hotchk155/banana-split/docs/dimensions.txt

4.375
4.625
4.875

0.25"
0.25"
0.4"

y = 0.555
sockets at y=0.53"
.025"

end of board 5.545
