hotchk155/banana-split/docs/banana.bmp

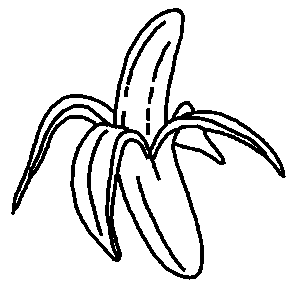
docs/banana.bmp
