hotchk155/banana-split/docs/schem.png

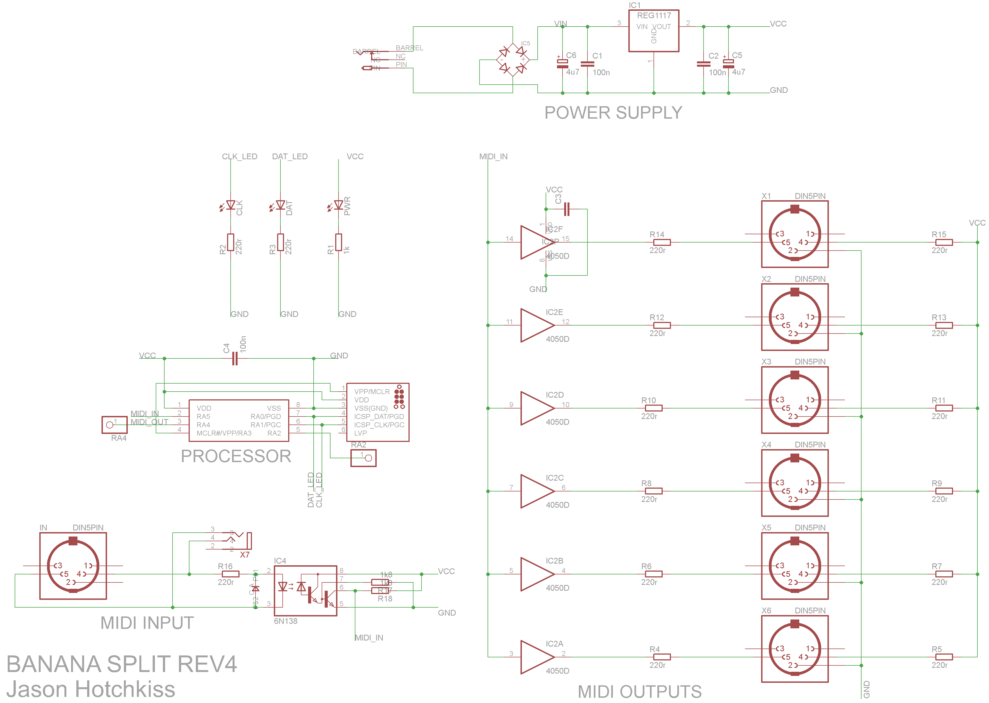
docs/schem.png
