hotchk155/banana-split/docs/banana-split-BOM.xlsx

BANANA SPLIT MIDI THRU - BILL OF MATERIALS
SIXTY FOUR PIXELS LIMITED
SURFACE MOUNT COMPONENTS
Designator | Value | Package | Manufacturer | Description | Source
R1 | 1k | 0805 | GENERIC | RESISTOR | SUPPLIER TO SOURCE
R2 | 220r | 0805 | GENERIC | RESISTOR | SUPPLIER TO SOURCE
R3 | 220r | 0805 | GENERIC | RESISTOR | SUPPLIER TO SOURCE
R4 | 220r | 0805 | GENERIC | RESISTOR | SUPPLIER TO SOURCE
R5 | 220r | 0805 | GENERIC | RESISTOR | SUPPLIER TO SOURCE
R6 | 220r | 0805 | GENERIC | RESISTOR | SUPPLIER TO SOURCE
R7 | 220r | 0805 | GENERIC | RESISTOR | SUPPLIER TO SOURCE
R8 | 220r | 0805 | GENERIC | RESISTOR | SUPPLIER TO SOURCE
R9 | 220r | 0805 | GENERIC | RESISTOR | SUPPLIER TO SOURCE
R10 | 220r | 0805 | GENERIC | RESISTOR | SUPPLIER TO SOURCE
R11 | 220r | 0805 | GENERIC | RESISTOR | SUPPLIER TO SOURCE
R12 | 220r | 0805 | GENERIC | RESISTOR | SUPPLIER TO SOURCE
R13 | 220r | 0805 | GENERIC | RESISTOR | SUPPLIER TO SOURCE
R14 | 220r | 0805 | GENERIC | RESISTOR | SUPPLIER TO SOURCE
R15 | 220r | 0805 | GENERIC | RESISTOR | SUPPLIER TO SOURCE
R16 | 220r | 0805 | GENERIC | RESISTOR | SUPPLIER TO SOURCE
R17 | 1k5 | 0805 | GENERIC | RESISTOR | SUPPLIER TO SOURCE
R18 | 1k5 | 0805 | GENERIC | RESISTOR | SUPPLIER TO SOURCE
R24 | 1k | 0805 | GENERIC | RESISTOR | SUPPLIER TO SOURCE
A | 0R | 0805 | GENERIC | RESISTOR | SUPPLIER TO SOURCE
B | Do not popupulate
C | 0R | 0805 | GENERIC | RESISTOR | SUPPLIER TO SOURCE
D | Do not popupulate
E | Do not popupulate
F | Do not popupulate
C1 | 100nF | 0805 | GENERIC | CERAMIC CAPACITOR | SUPPLIER TO SOURCE
C2 | 100nF | 0805 | GENERIC | CERAMIC CAPACITOR | SUPPLIER TO SOURCE
C3 | 100nF | 0805 | GENERIC | CERAMIC CAPACITOR | SUPPLIER TO SOURCE
C4 | 100nF | 0805 | GENERIC | CERAMIC CAPACITOR | SUPPLIER TO SOURCE
C7 | 10nF (TEN) | 0805 | GENERIC | CERAMIC CAPACITOR | SUPPLIER TO SOURCE
D1 | TS4148 | 0805 | GENERIC | SMALL SIGNAL DIODE | SUPPLIED BY CUSTOMER
D2 | MBR0520 | SOD123 | GENERIC | SCHOTTKY DIODE
D3 | MBR0520 | SOD123 | GENERIC | SCHOTTKY DIODE
D4 | MBR0520 | SOD123 | GENERIC | SCHOTTKY DIODE
D5 | MBR0520 | SOD123 | GENERIC | SCHOTTKY DIODE
IC1 | LD1117S50CTR | SOT-223-3 | ST MICRO | +5V VOLTAGE REGULATOR | SUPPLIED BY CUSTOMER
IC2 | CD4050BD | SOIC-16 | TEXAS INSTRUMENTS | HEX NONINVERTING BUFFER | SUPPLIED BY CUSTOMER
IC3 | PIC12F1822-I/P | SOIC-8 | MICROCHIP | MICROCONTROLLER | SUPPLIED BY CUSTOMER
THRU HOLE COMPONENTS (DO NOT POPULATE)
C5 | 4.7uF/ 50V | RADIAL 2MM PITCH | GENERIC | ALUMINIUM ELECTROLYTIC CAPACITOR | DO NOT POPULATE
C6 | 4.7uF/ 50V | RADIAL 2MM PITCH | GENERIC | ALUMINIUM ELECTROLYTIC CAPACITOR | DO NOT POPULATE
IC4 | 6N138 | DIP-8 | GENERIC | OPTO ISOLATOR DARLINGTON OUTPUT | DO NOT POPULATE
CLK | BLUE | 2 x 5 x 7 mm | GENERIC | RECTANGULAR LENS LED | DO NOT POPULATE
DAT | YELLOW | 2 x 5 x 7 mm | GENERIC | RECTANGULAR LENS LED | DO NOT POPULATE
PWR | RED | 2 x 5 x 7 mm | GENERIC | RECTANGULAR LENS LED | DO NOT POPULATE
IN | DS1093-07-BN50X |  | TRUCONNECT | 5 Way 180 Degree DIN PCB Socket | DO NOT POPULATE
X1 | DS1093-07-BN50X |  | TRUCONNECT | 5 Way 180 Degree DIN PCB Socket | DO NOT POPULATE
X2 | DS1093-07-BN50X |  | TRUCONNECT | 5 Way 180 Degree DIN PCB Socket | DO NOT POPULATE
X3 | DS1093-07-BN50X |  | TRUCONNECT | 5 Way 180 Degree DIN PCB Socket | DO NOT POPULATE
X4 | DS1093-07-BN50X |  | TRUCONNECT | 5 Way 180 Degree DIN PCB Socket | DO NOT POPULATE
X5 | DS1093-07-BN50X |  | TRUCONNECT | 5 Way 180 Degree DIN PCB Socket | DO NOT POPULATE
X6 | DS1093-07-BN50X |  | TRUCONNECT | 5 Way 180 Degree DIN PCB Socket | DO NOT POPULATE
X7 | PJ-360 |  | TRUCONNECT | UNSWITCHED STEREO VERTICAL JACK SOCKET | DO NOT POPULATE
X8 | AD-426A |  | RVFM (RAPID) | 2.1MM DC POWER SOCKET | DO NOT POPULATE
