hotchk155/banana-split/hardware/banana-split-bom-jlc.xls

Comment | Designator | Footprint | JLCPCB Part #
MBR0520 | D5,D3,D2,D4,D5,D3,D2,D4,D5,D3,D2,D4,D5,D3,D2,D4 | SOD-123 | C23848
1k | R1,R24,R1,R24 | 0805 | C17513
CD4050BD | IC2 | SO16 | C352821
TS4148 | D1 | 0805 | C109001
PIC12F1822-I/P | IC3 | SO08 | C60039
220r | R6,R12,R13,R15,R16,R2,R4,R7,R9,R11,R14,R5,R3,R10,R8,R6,R12,R13,R15,R16,R2,R4,R7,R9,R11,R14,R5,R3,R10,R8,R6,R12,R13,R15,R16,R2,R4,R7,R9,R11,R14,R5,R3,R10,R8,R6,R12,R13,R15,R16,R2,R4,R7,R9,R11,R14,R5,R3,R10,R8,R6,R12,R13,R15,R16,R2,R4,R7,R9,R11,R14,R5,R3,R10,R8,R6,R12,R13,R15,R16,R2,R4,R7,R9,R11,R14,R5,R3,R10,R8,R6,R12,R13,R15,R16,R2,R4,R7,R9,R11,R14,R5,R3,R10,R8,R6,R12,R13,R15,R16,R2,R4,R7,R9,R11,R14,R5,R3,R10,R8,R6,R12,R13,R15,R16,R2,R4,R7,R9,R11,R14,R5,R3,R10,R8,R6,R12,R13,R15,R16,R2,R4,R7,R9,R11,R14,R5,R3,R10,R8,R6,R12,R13,R15,R16,R2,R4,R7,R9,R11,R14,R5,R3,R10,R8,R6,R12,R13,R15,R16,R2,R4,R7,R9,R11,R14,R5,R3,R10,R8,R6,R12,R13,R15,R16,R2,R4,R7,R9,R11,R14,R5,R3,R10,R8,R6,R12,R13,R15,R16,R2,R4,R7,R9,R11,R14,R5,R3,R10,R8,R6,R12,R13,R15,R16,R2,R4,R7,R9,R11,R14,R5,R3,R10,R8 | 0805 | C17557
1k5 | R18,R17,R18,R17 | 0805 | C4310
100nF | C3,C4,C7,C2,C1,C3,C4,C7,C2,C1,C3,C4,C7,C2,C1,C3,C4,C7,C2,C1,C3,C4,C7,C2,C1 | 0805 | C49678
LD1117S50CTR | IC1 | SOT223 | C81157
