hotchk155/banana-split/hardware/banana-split-bom.xlsx

Comment | Designator | Footprint | JLCPCB Part #（optional）
0r | A | 0805
DNP | B
0r | C | 0805
100nF | C1 | 0805
100nF | C2 | 0805
100nF | C3 | 0805
100nF | C4 | 0805
100nF | C7 | 0805
DNP | D
TS4148 | D1 | 0805
MBR0520 | D2 | SOD-123
MBR0520 | D3 | SOD-123
MBR0520 | D4 | SOD-123
MBR0520 | D5 | SOD-123
DNP | E
DNP | F
LD1117S50CTR | IC1 | SOT223
CD4050BD | IC2 | SO16
PIC12F1822-I/P | IC3 | SO08
1k | R1 | 0805
220r | R2 | 0805
220r | R3 | 0805
220r | R4 | 0805
220r | R5 | 0805
220r | R6 | 0805
220r | R7 | 0805
220r | R8 | 0805
220r | R9 | 0805
220r | R10 | 0805
220r | R11 | 0805
220r | R12 | 0805
220r | R13 | 0805
220r | R14 | 0805
220r | R15 | 0805
220r | R16 | 0805
1k5 | R17 | 0805
1k5 | R18 | 0805
1k | R24 | 0805
