hotchk155/banana-split/hardware/banana-split.brd

## EAGLE design hardware/banana-split.brd (2019-09-07)

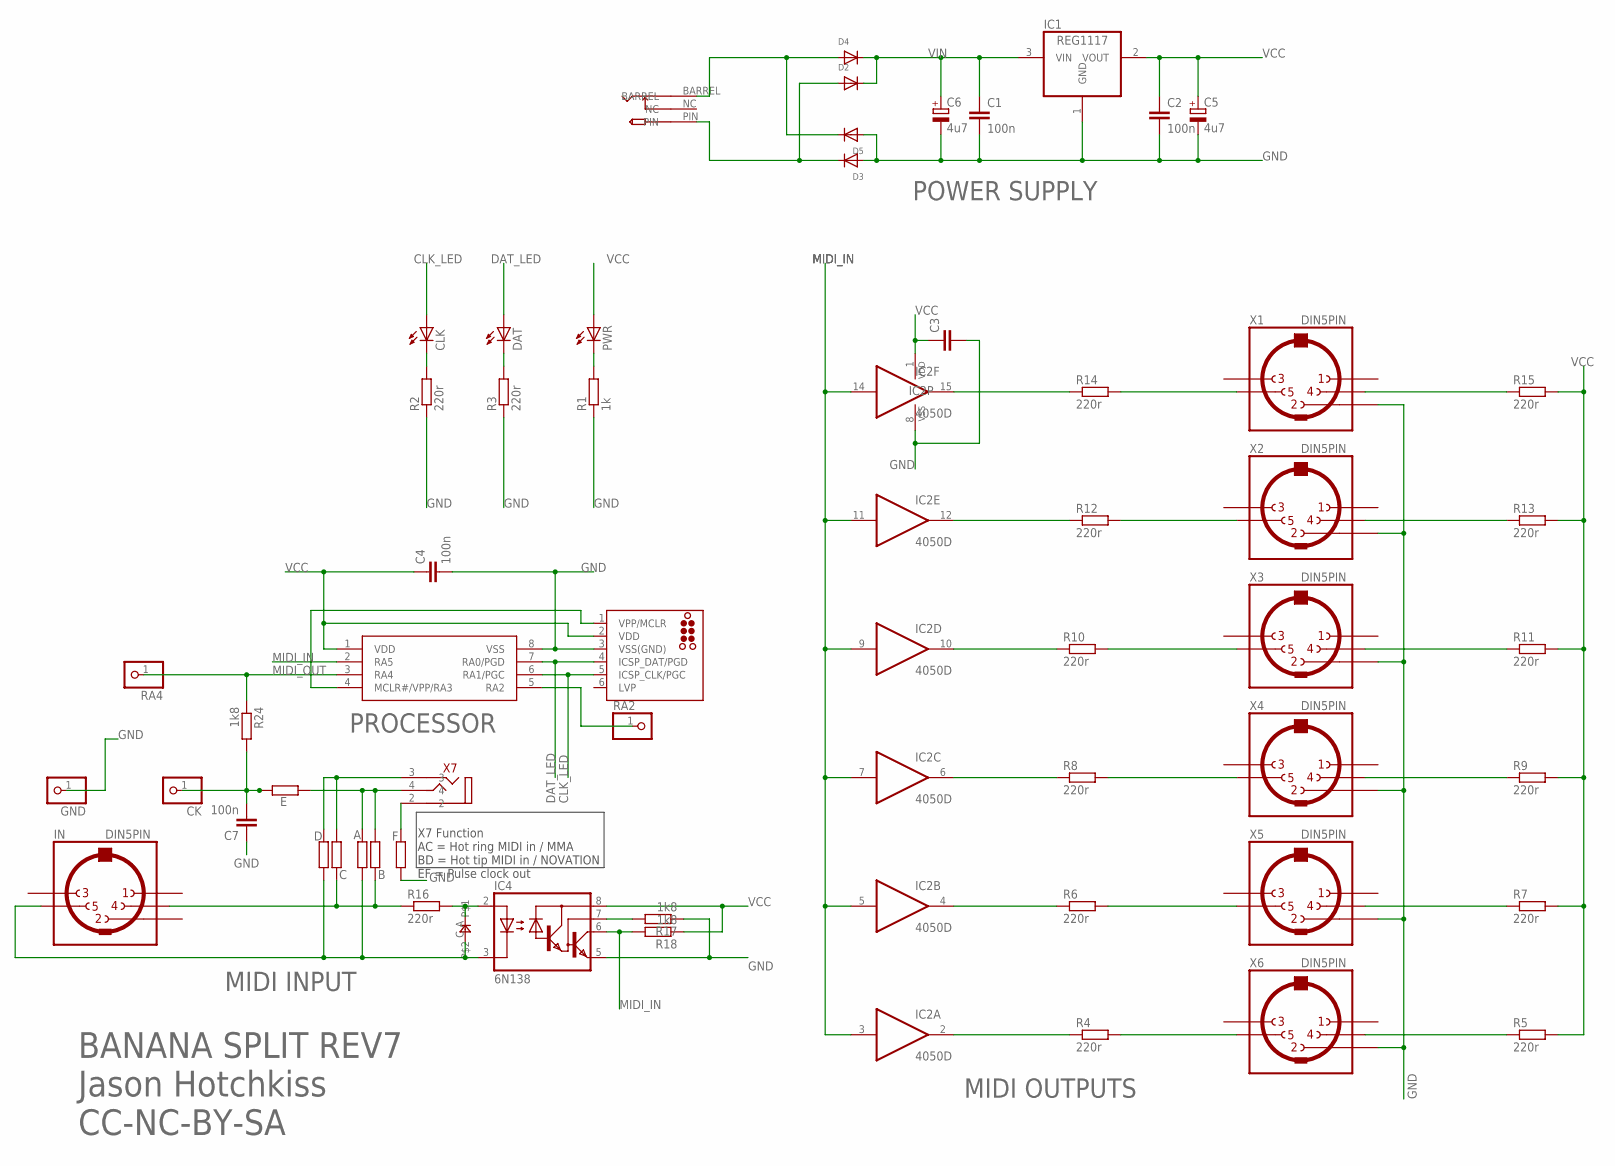
[picture p20: schematic banana-split.sch]

Parts:
A: 1k8; R0805
B: 1k8; R0805
C: 1k8; R0805
C1, C2, C4, C7: 100n; C0805
C3: C-EUC0805; C0805
C5, C6: 4u7; E2-4
CK: PINHD-1X1; 1X01
CLK: LED3MM
D: 1k8; R0805
D1: 0805DIODE
D2, D3, D4, D5: DIODESOD-123; SOD-123
DAT: LED3MM
E: 1k8; R0805
F: 1k8; R0805
GND: PINHD-1X1; 1X01
IC1: REG1117; SOT223
IC2: 4050D; SO16
IC3: PIC12F1822SO08; SO08
IC4: 6N138; DIL08
ICSP: TC2030-MCP-NL
IN: DIN5PIN; EDGEDIN
PWR: LED3MM
R1: 1k; R0805
R2, R3, R4, R5, R6, R7, R8, R9, R10, R11, R12, R13, R14, R15, R16: 220r; R0805
R17, R18, R24: 1k8; R0805
RA2, RA4: PINHD-1X1; 1X01
U$1: PWR_SOCKET_2_1MM
X1, X2, X3, X4, X5, X6: DIN5PIN; EDGEDIN
X7: VERTICAL_3_5MM_SOCKET

Connections:
CLK: CLK.K (C), R2.2
CLK_LED: CLK.A, IC3.6 (RA1/PGC), ICSP.5 (ICSP_CLK/PGC)
DAT_LED: DAT.A, IC3.7 (RA0/PGD), ICSP.4 (ICSP_DAT/PGD)
GND: C1.2, C2.2, C3.2, C4.2, C5.-, C6.-, C7.1, D3.A, D5.A, F.1, GND.1, IC1.1 (GND), IC2.8 (VSS), IC3.8 (VSS), IC4.5 (GND), ICSP.3 (VSS(GND)), R1.1, R2.1, R3.1, R17.1, X1.2, X2.2, X3.2, X4.2, X5.2, X6.2
MIDI_IN: IC2.3 (I), IC2.5 (I), IC2.7 (I), IC2.9 (I), IC2.11 (I), IC2.14 (I), IC3.2 (RA5), IC4.6 (VO), R18.2
MIDI_OUT: IC3.3 (RA4), R24.1, RA4.1
unnamed: R14.2, X1.5
unnamed: R12.2, X2.5
unnamed: R10.2, X3.5
unnamed: R8.2, X4.5
unnamed: R6.2, X5.5
unnamed: R4.2, X6.5
unnamed: IC2.15 (O), R14.1
unnamed: IC2.12 (O), R12.1
unnamed: IC2.10 (O), R10.1
unnamed: IC2.6 (O), R8.1
unnamed: IC2.2 (O), R4.1
unnamed: IC2.4 (O), R6.1
unnamed: PWR.K (C), R1.2
unnamed: R15.1, X1.4
unnamed: R13.1, X2.4
unnamed: R11.1, X3.4
unnamed: R9.1, X4.4
unnamed: R7.1, X5.4
unnamed: R5.1, X6.4
unnamed: B.1, C.1, IN.4, R16.1
unnamed: D1.A, IC4.2 (A), R16.2
unnamed: IC4.7 (VB), R17.2
unnamed: DAT.K (C), R3.2
unnamed: A.1, D.1, D1.C, IC4.3 (C), IN.5
unnamed: IC3.5 (RA2), RA2.1
unnamed: C.2, D.2, X7.3
unnamed: D4.A, D5.C, U$1.BARREL
unnamed: D2.A, D3.C, U$1.PIN
unnamed: F.2, X7.2
unnamed: A.2, B.2, E.2, X7.4
unnamed: C7.2, CK.1, E.1, R24.2
unnamed: IC3.4 (MCLR#/VPP/RA3), ICSP.1 (VPP/MCLR)
VCC: C2.1, C3.1, C4.1, C5.+, IC1.2 (VOUT), IC2.1 (VDD), IC3.1 (VDD), IC4.8 (VCC), ICSP.2 (VDD), PWR.A, R5.2, R7.2, R9.2, R11.2, R13.2, R15.2, R18.1
VIN: C1.1, C6.+, D2.C, D4.C, IC1.3 (VIN)

Notes on the sheet:
POWER SUPPLY
MIDI OUTPUTS
MIDI INPUT
PROCESSOR
BANANA SPLIT REV7
Jason Hotchkiss CC-NC-BY-SA
X7 Function AC = Hot ring MIDI in / MMA BD = Hot tip MIDI in / NOVATION EF = Pulse clock out

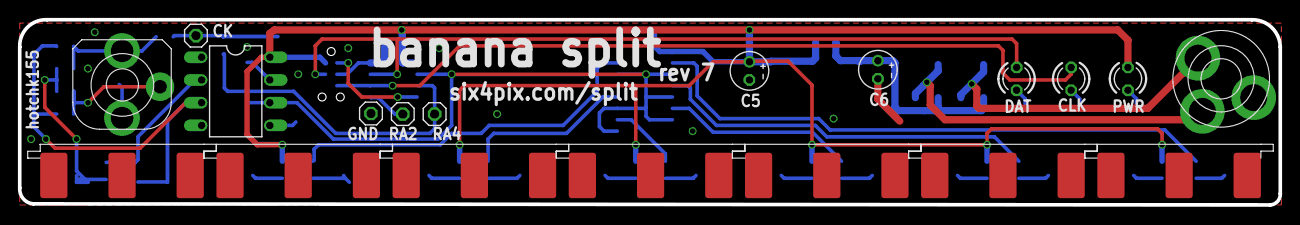
[picture p21: board banana-split.brd from above]

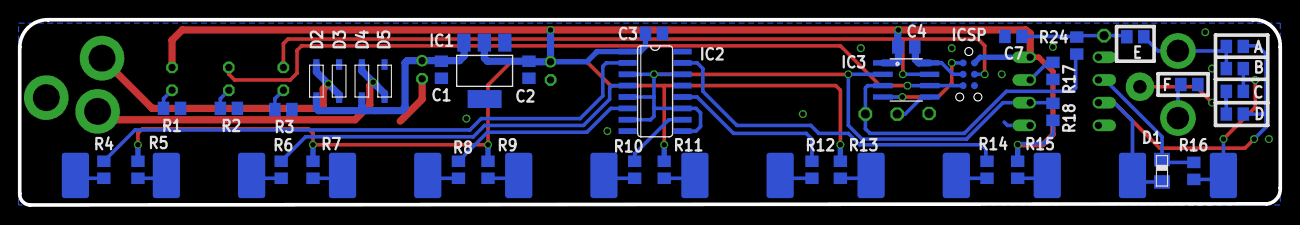
[picture p22: board banana-split.brd from below]

Board: 2 copper layers, 140.8 x 20.7 mm, 58 parts (39 on the bottom side), 40 nets.
