hotchk155/banana-split/panel/banana-split-panel.brd

## EAGLE design panel/banana-split-panel.brd (2020-06-03)

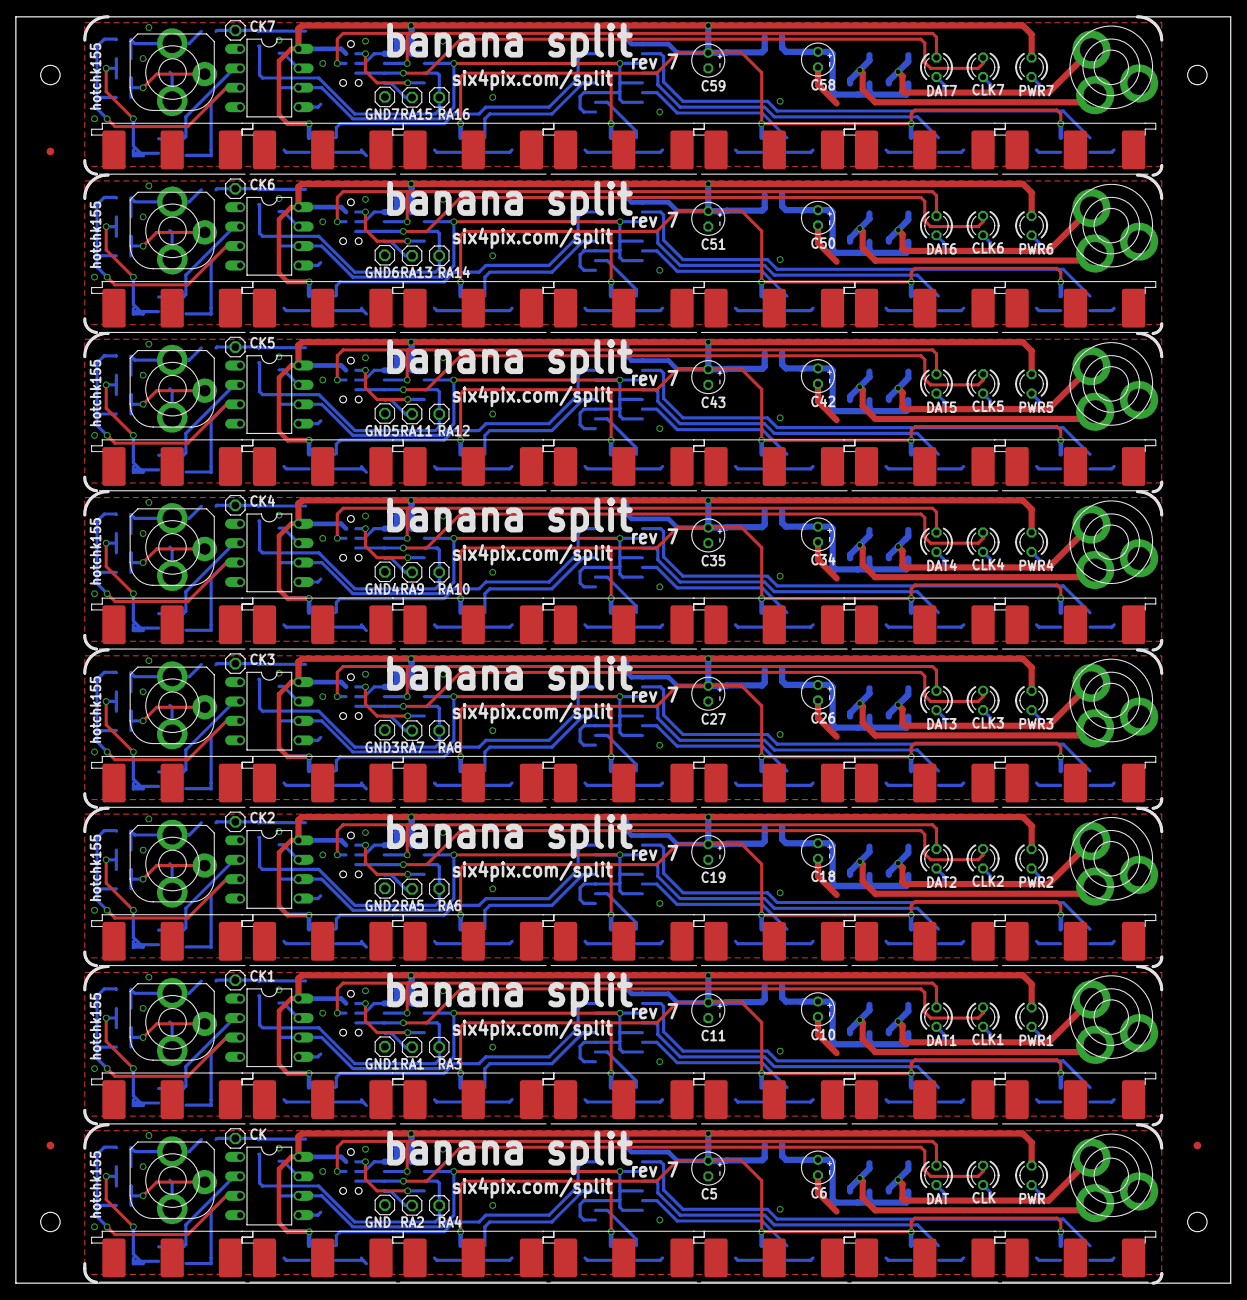
[picture p23: board banana-split-panel.brd from above]

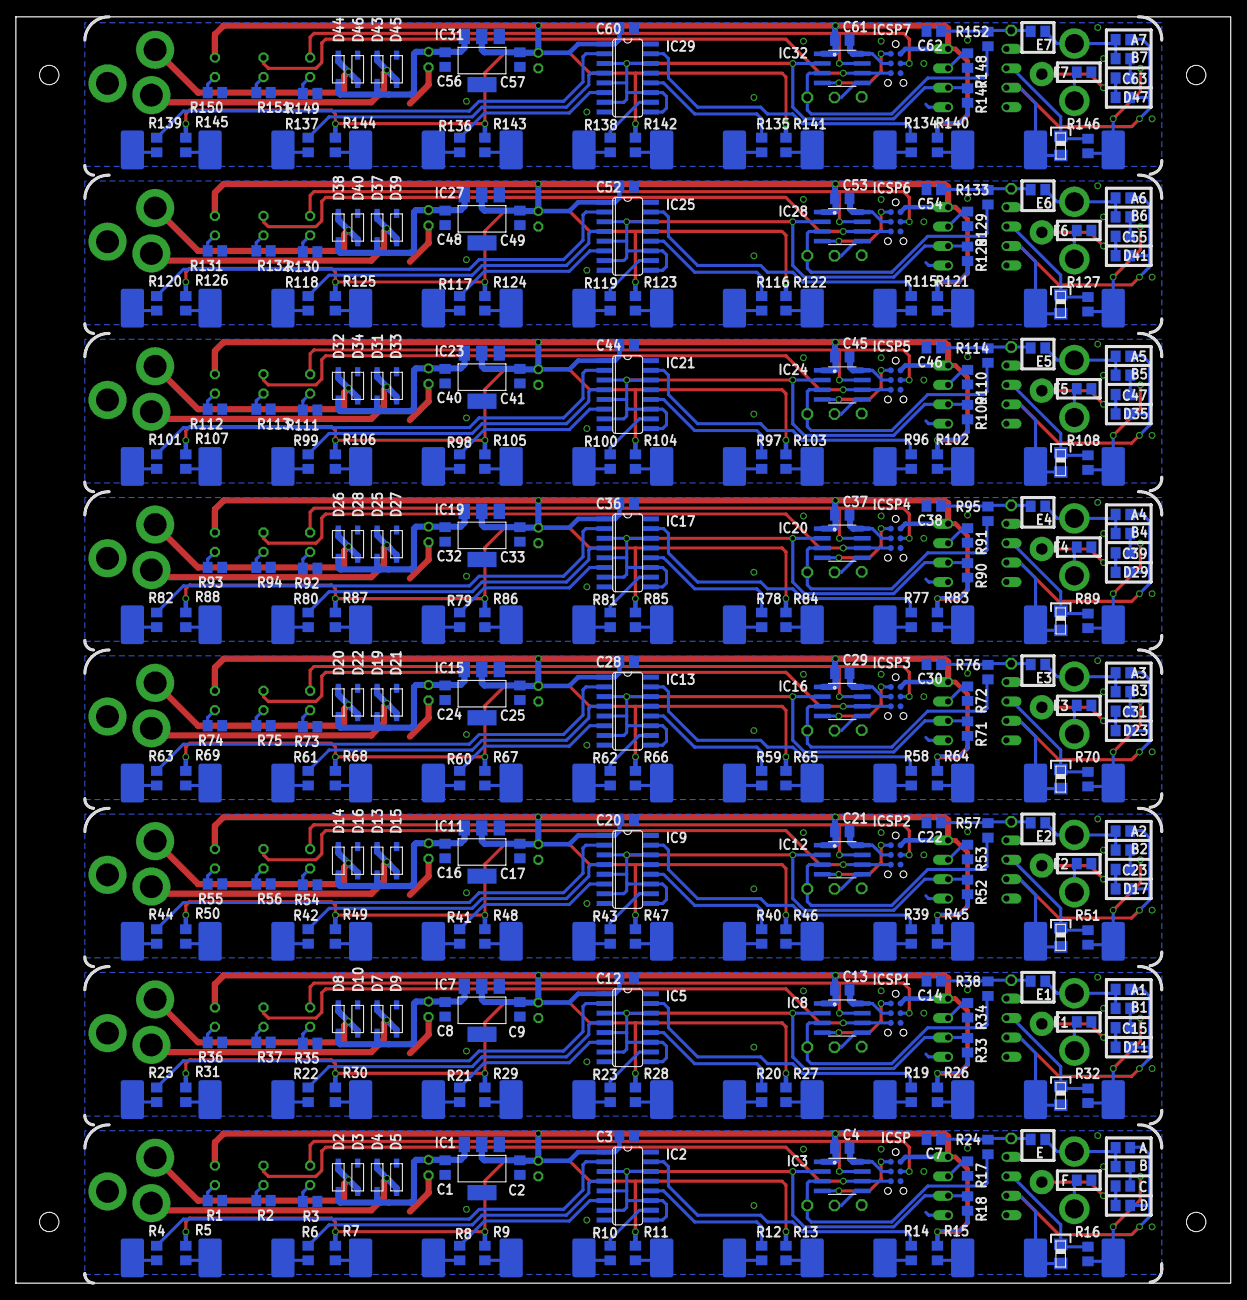
[picture p24: board banana-split-panel.brd from below]

Board: 2 copper layers, 158.9 x 165.6 mm, 467 parts (312 on the bottom side), 320 nets.

Parts:
A, A1, A2, A3, A4, A5, A6, A7: 1k8; R0805
B, B1, B2, B3, B4, B5, B6, B7: 1k8; R0805
C, C15, C23, C31, C39, C47, C55, C63: 1k8; R0805
C1, C2, C4, C7, C8, C9, C13, C14, C16, C17, C21, C22, C24, C25, C29, C30, C32, C33, C37, C38, C40, C41, C45, C46, C48, C49, C53, C54, C56, C57, C61, C62: 100n; C0805
C3, C12, C20, C28, C36, C44, C52, C60: C0805
C5, C6, C10, C11, C18, C19, C26, C27, C34, C35, C42, C43, C50, C51, C58, C59: 4u7; E2-4
CK, CK1, CK2, CK3, CK4, CK5, CK6, CK7: 1X01
CLK, CLK1, CLK2, CLK3, CLK4, CLK5, CLK6, CLK7: LED3MM
D, D11, D17, D23, D29, D35, D41, D47: 1k8; R0805
D1, D6, D12, D18, D24, D30, D36, D42: 0805DIODE
D2, D3, D4, D5, D7, D8, D9, D10, D13, D14, D15, D16, D19, D20, D21, D22, D25, D26, D27, D28, D31, D32, D33, D34, D37, D38, D39, D40, D43, D44, D45, D46: SOD-123
DAT, DAT1, DAT2, DAT3, DAT4, DAT5, DAT6, DAT7: LED3MM
E, E1, E2, E3, E4, E5, E6, E7: 1k8; R0805
E$1, E$2, E$3: FIDUCIAL_1MM
F, F1, F2, F3, F4, F5, F6, F7: 1k8; R0805
GND, GND1, GND2, GND3, GND4, GND5, GND6, GND7: 1X01
IC1, IC7, IC11, IC15, IC19, IC23, IC27, IC31: REG1117; SOT223
IC2, IC5, IC9, IC13, IC17, IC21, IC25, IC29: 4050D; SO16
IC3, IC8, IC12, IC16, IC20, IC24, IC28, IC32: PIC12F1822SO08; SO08
IC4, IC6, IC10, IC14, IC18, IC22, IC26, IC30: 6N138; DIL08
ICSP, ICSP1, ICSP2, ICSP3, ICSP4, ICSP5, ICSP6, ICSP7: TC2030-MCP-NL
IN, IN1, IN2, IN3, IN4, IN5, IN6, IN7: DIN5PIN; EDGEDIN
PWR, PWR1, PWR2, PWR3, PWR4, PWR5, PWR6, PWR7: LED3MM
R1, R36, R55, R74, R93, R112, R131, R150: 1k; R0805
R2, R3, R4, R5, R6, R7, R8, R9, R10, R11, R12, R13, R14, R15, R16, R19, R20, R21, R22, R23, R25, R26, R27, R28, R29, R30, R31, R32, R35, R37, R39, R40, R41, R42, R43, R44, R45, R46, R47, R48, R49, R50, R51, R54, R56, R58, R59, R60, R61, R62, R63, R64, R65, R66, R67, R68, R69, R70, R73, R75, R77, R78, R79, R80, R81, R82, R83, R84, R85, R86, R87, R88, R89, R92, R94, R96, R97, R98, R99, R100, R101, R102, R103, R104, R105, R106, R107, R108, R111, R113, R115, R116, R117, R118, R119, R120, R121, R122, R123, R124, R125, R126, R127, R130, R132, R134, R135, R136, R137, R138, R139, R140, R141, R142, R143, R144, R145, R146, R149, R151: 220r; R0805
R17, R18, R24, R33, R34, R38, R52, R53, R57, R71, R72, R76, R90, R91, R95, R109, R110, R114, R128, R129, R133, R147, R148, R152: 1k8; R0805
RA1, RA2, RA3, RA4, RA5, RA6, RA7, RA8, RA9, RA10, RA11, RA12, RA13, RA14, RA15, RA16: 1X01
U$1, U$2, U$3, U$4, U$5, U$6, U$7, U$8: PWR_SOCKET_2_1MM
X1, X2, X3, X4, X5, X6, X8, X9, X10, X11, X12, X13, X15, X16, X17, X18, X19, X20, X22, X23, X24, X25, X26, X27, X29, X30, X31, X32, X33, X34, X36, X37, X38, X39, X40, X41, X43, X44, X45, X46, X47, X48, X50, X51, X52, X53, X54, X55: DIN5PIN; EDGEDIN
X7, X14, X21, X28, X35, X42, X49, X56: VERTICAL_3_5MM_SOCKET

Connections:
CLK: CLK.K, R2.2
CLK1: CLK1.K, R37.2
CLK2: CLK2.K, R56.2
CLK3: CLK3.K, R75.2
CLK4: CLK4.K, R94.2
CLK5: CLK5.K, R113.2
CLK6: CLK6.K, R132.2
CLK7: CLK7.K, R151.2
CLK_LED: CLK.A, IC3.6, ICSP.5
CLK_LED1: CLK1.A, IC8.6, ICSP1.5
CLK_LED2: CLK2.A, IC12.6, ICSP2.5
CLK_LED3: CLK3.A, IC16.6, ICSP3.5
CLK_LED4: CLK4.A, IC20.6, ICSP4.5
CLK_LED5: CLK5.A, IC24.6, ICSP5.5
CLK_LED6: CLK6.A, IC28.6, ICSP6.5
CLK_LED7: CLK7.A, IC32.6, ICSP7.5
DAT_LED: DAT.A, IC3.7, ICSP.4
DAT_LED1: DAT1.A, IC8.7, ICSP1.4
DAT_LED2: DAT2.A, IC12.7, ICSP2.4
DAT_LED3: DAT3.A, IC16.7, ICSP3.4
DAT_LED4: DAT4.A, IC20.7, ICSP4.4
DAT_LED5: DAT5.A, IC24.7, ICSP5.4
DAT_LED6: DAT6.A, IC28.7, ICSP6.4
DAT_LED7: DAT7.A, IC32.7, ICSP7.4
GND: C1.2, C2.2, C3.2, C4.2, C5.-, C6.-, C7.1, D3.A, D5.A, F.1, GND.1, IC1.1, IC2.8, IC3.8, IC4.5, ICSP.3, R1.1, R2.1, R3.1, R17.1, X1.2, X2.2, X3.2, X4.2, X5.2, X6.2
GND1: C8.2, C9.2, C10.-, C11.-, C12.2, C13.2, C14.1, D9.A, D10.A, F1.1, GND1.1, IC5.8, IC6.5, IC7.1, IC8.8, ICSP1.3, R34.1, R35.1, R36.1, R37.1, X8.2, X9.2, X10.2, X11.2, X12.2, X13.2
GND2: C16.2, C17.2, C18.-, C19.-, C20.2, C21.2, C22.1, D15.A, D16.A, F2.1, GND2.1, IC9.8, IC10.5, IC11.1, IC12.8, ICSP2.3, R53.1, R54.1, R55.1, R56.1, X15.2, X16.2, X17.2, X18.2, X19.2, X20.2
GND3: C24.2, C25.2, C26.-, C27.-, C28.2, C29.2, C30.1, D21.A, D22.A, F3.1, GND3.1, IC13.8, IC14.5, IC15.1, IC16.8, ICSP3.3, R72.1, R73.1, R74.1, R75.1, X22.2, X23.2, X24.2, X25.2, X26.2, X27.2
GND4: C32.2, C33.2, C34.-, C35.-, C36.2, C37.2, C38.1, D27.A, D28.A, F4.1, GND4.1, IC17.8, IC18.5, IC19.1, IC20.8, ICSP4.3, R91.1, R92.1, R93.1, R94.1, X29.2, X30.2, X31.2, X32.2, X33.2, X34.2
GND5: C40.2, C41.2, C42.-, C43.-, C44.2, C45.2, C46.1, D33.A, D34.A, F5.1, GND5.1, IC21.8, IC22.5, IC23.1, IC24.8, ICSP5.3, R110.1, R111.1, R112.1, R113.1, X36.2, X37.2, X38.2, X39.2, X40.2, X41.2
GND6: C48.2, C49.2, C50.-, C51.-, C52.2, C53.2, C54.1, D39.A, D40.A, F6.1, GND6.1, IC25.8, IC26.5, IC27.1, IC28.8, ICSP6.3, R129.1, R130.1, R131.1, R132.1, X43.2, X44.2, X45.2, X46.2, X47.2, X48.2
GND7: C56.2, C57.2, C58.-, C59.-, C60.2, C61.2, C62.1, D45.A, D46.A, F7.1, GND7.1, IC29.8, IC30.5, IC31.1, IC32.8, ICSP7.3, R148.1, R149.1, R150.1, R151.1, X50.2, X51.2, X52.2, X53.2, X54.2, X55.2
MIDI_IN: IC2.3, IC2.5, IC2.7, IC2.9, IC2.11, IC2.14, IC3.2, IC4.6, R18.2
MIDI_IN1: IC5.3, IC5.5, IC5.7, IC5.9, IC5.11, IC5.14, IC6.6, IC8.2, R33.2
MIDI_IN2: IC9.3, IC9.5, IC9.7, IC9.9, IC9.11, IC9.14, IC10.6, IC12.2, R52.2
MIDI_IN3: IC13.3, IC13.5, IC13.7, IC13.9, IC13.11, IC13.14, IC14.6, IC16.2, R71.2
MIDI_IN4: IC17.3, IC17.5, IC17.7, IC17.9, IC17.11, IC17.14, IC18.6, IC20.2, R90.2
MIDI_IN5: IC21.3, IC21.5, IC21.7, IC21.9, IC21.11, IC21.14, IC22.6, IC24.2, R109.2
MIDI_IN6: IC25.3, IC25.5, IC25.7, IC25.9, IC25.11, IC25.14, IC26.6, IC28.2, R128.2
MIDI_IN7: IC29.3, IC29.5, IC29.7, IC29.9, IC29.11, IC29.14, IC30.6, IC32.2, R147.2
MIDI_OUT: IC3.3, R24.1, RA4.1
MIDI_OUT1: IC8.3, R38.1, RA3.1
MIDI_OUT2: IC12.3, R57.1, RA6.1
MIDI_OUT3: IC16.3, R76.1, RA8.1
MIDI_OUT4: IC20.3, R95.1, RA10.1
MIDI_OUT5: IC24.3, R114.1, RA12.1
MIDI_OUT6: IC28.3, R133.1, RA14.1
MIDI_OUT7: IC32.3, R152.1, RA16.1
unnamed: R14.2, X1.5
unnamed: R12.2, X2.5
unnamed: R10.2, X3.5
unnamed: R8.2, X4.5
unnamed: R6.2, X5.5
unnamed: R4.2, X6.5
unnamed: IC2.15, R14.1
unnamed: IC2.12, R12.1
unnamed: IC2.10, R10.1
unnamed: IC2.6, R8.1
unnamed: IC2.2, R4.1
unnamed: IC2.4, R6.1
unnamed: PWR.K, R1.2
unnamed: R15.1, X1.4
unnamed: R13.1, X2.4
unnamed: R11.1, X3.4
unnamed: R9.1, X4.4
unnamed: R7.1, X5.4
unnamed: R5.1, X6.4
unnamed: B.1, C.1, IN.4, R16.1
unnamed: D1.A, IC4.2, R16.2
unnamed: IC4.7, R17.2
unnamed: DAT.K, R3.2
unnamed: A.1, D.1, D1.C, IC4.3, IN.5
unnamed: IC3.5, RA2.1
unnamed: C.2, D.2, X7.3
unnamed: D4.A, D5.C, U$1.BARREL
unnamed: D2.A, D3.C, U$1.PIN
unnamed: F.2, X7.2
unnamed: A.2, B.2, E.2, X7.4
unnamed: C7.2, CK.1, E.1, R24.2
unnamed: R19.2, X8.5
unnamed: IC3.4, ICSP.1
unnamed: R20.2, X9.5
unnamed: R23.2, X10.5
unnamed: R21.2, X11.5
unnamed: R22.2, X12.5
unnamed: R25.2, X13.5
unnamed: R26.1, X8.4
unnamed: R27.1, X9.4
unnamed: R28.1, X10.4
unnamed: R29.1, X11.4
unnamed: R30.1, X12.4
unnamed: R31.1, X13.4
unnamed: B1.1, C15.1, IN1.4, R32.1
unnamed: D6.A, IC6.2, R32.2
unnamed: IC6.7, R34.2
unnamed: A1.1, D6.C, D11.1, IC6.3, IN1.5
unnamed: DAT1.K, R35.2
unnamed: D7.A, D9.C, U$2.BARREL
unnamed: D8.A, D10.C, U$2.PIN
unnamed: IC8.4, ICSP1.1
unnamed: PWR1.K, R36.2
unnamed: IC8.5, RA1.1
unnamed: IC5.15, R19.1
unnamed: IC5.12, R20.1
unnamed: IC5.10, R23.1
unnamed: IC5.6, R21.1
unnamed: IC5.2, R25.1
unnamed: IC5.4, R22.1
unnamed: C15.2, D11.2, X14.3
unnamed: A1.2, B1.2, E1.2, X14.4
unnamed: C14.2, CK1.1, E1.1, R38.2
unnamed: F1.2, X14.2
unnamed: R39.2, X15.5
unnamed: R40.2, X16.5
unnamed: R43.2, X17.5
unnamed: R41.2, X18.5
unnamed: R42.2, X19.5
unnamed: R44.2, X20.5
unnamed: R45.1, X15.4
unnamed: R46.1, X16.4
unnamed: R47.1, X17.4
unnamed: R48.1, X18.4
unnamed: R49.1, X19.4
unnamed: R50.1, X20.4
unnamed: B2.1, C23.1, IN2.4, R51.1
unnamed: D12.A, IC10.2, R51.2
unnamed: IC10.7, R53.2
unnamed: A2.1, D12.C, D17.1, IC10.3, IN2.5
unnamed: DAT2.K, R54.2
unnamed: D13.A, D15.C, U$3.BARREL
unnamed: D14.A, D16.C, U$3.PIN
unnamed: IC12.4, ICSP2.1
unnamed: PWR2.K, R55.2
unnamed: IC12.5, RA5.1
unnamed: IC9.15, R39.1
unnamed: IC9.12, R40.1
unnamed: IC9.10, R43.1
unnamed: IC9.6, R41.1
unnamed: IC9.2, R44.1
unnamed: IC9.4, R42.1
unnamed: C23.2, D17.2, X21.3
unnamed: A2.2, B2.2, E2.2, X21.4
unnamed: C22.2, CK2.1, E2.1, R57.2
unnamed: F2.2, X21.2
unnamed: R58.2, X22.5
unnamed: R59.2, X23.5
unnamed: R62.2, X24.5
unnamed: R60.2, X25.5
unnamed: R61.2, X26.5
unnamed: R63.2, X27.5
unnamed: R64.1, X22.4
unnamed: R65.1, X23.4
unnamed: R66.1, X24.4
unnamed: R67.1, X25.4
unnamed: R68.1, X26.4
unnamed: R69.1, X27.4
unnamed: B3.1, C31.1, IN3.4, R70.1
unnamed: D18.A, IC14.2, R70.2
unnamed: IC14.7, R72.2
unnamed: A3.1, D18.C, D23.1, IC14.3, IN3.5
unnamed: DAT3.K, R73.2
unnamed: D19.A, D21.C, U$4.BARREL
unnamed: D20.A, D22.C, U$4.PIN
unnamed: IC16.4, ICSP3.1
unnamed: PWR3.K, R74.2
unnamed: IC16.5, RA7.1
unnamed: IC13.15, R58.1
unnamed: IC13.12, R59.1
unnamed: IC13.10, R62.1
unnamed: IC13.6, R60.1
unnamed: IC13.2, R63.1
unnamed: IC13.4, R61.1
unnamed: C31.2, D23.2, X28.3
unnamed: A3.2, B3.2, E3.2, X28.4
unnamed: C30.2, CK3.1, E3.1, R76.2
unnamed: F3.2, X28.2
unnamed: R77.2, X29.5
unnamed: R78.2, X30.5
unnamed: R81.2, X31.5
unnamed: R79.2, X32.5
unnamed: R80.2, X33.5
unnamed: R82.2, X34.5
unnamed: R83.1, X29.4
unnamed: R84.1, X30.4
unnamed: R85.1, X31.4
unnamed: R86.1, X32.4
unnamed: R87.1, X33.4
unnamed: R88.1, X34.4
unnamed: B4.1, C39.1, IN4.4, R89.1
unnamed: D24.A, IC18.2, R89.2
unnamed: IC18.7, R91.2
unnamed: A4.1, D24.C, D29.1, IC18.3, IN4.5
unnamed: DAT4.K, R92.2
unnamed: D25.A, D27.C, U$5.BARREL
unnamed: D26.A, D28.C, U$5.PIN
unnamed: IC20.4, ICSP4.1
unnamed: PWR4.K, R93.2
unnamed: IC20.5, RA9.1
unnamed: IC17.15, R77.1
unnamed: IC17.12, R78.1
unnamed: IC17.10, R81.1
unnamed: IC17.6, R79.1
unnamed: IC17.2, R82.1
unnamed: IC17.4, R80.1
unnamed: C39.2, D29.2, X35.3
unnamed: A4.2, B4.2, E4.2, X35.4
unnamed: C38.2, CK4.1, E4.1, R95.2
unnamed: F4.2, X35.2
unnamed: R96.2, X36.5
unnamed: R97.2, X37.5
unnamed: R100.2, X38.5
unnamed: R98.2, X39.5
unnamed: R99.2, X40.5
unnamed: R101.2, X41.5
unnamed: R102.1, X36.4
unnamed: R103.1, X37.4
unnamed: R104.1, X38.4
unnamed: R105.1, X39.4
unnamed: R106.1, X40.4
unnamed: R107.1, X41.4
unnamed: B5.1, C47.1, IN5.4, R108.1
unnamed: D30.A, IC22.2, R108.2
unnamed: IC22.7, R110.2
unnamed: A5.1, D30.C, D35.1, IC22.3, IN5.5
unnamed: DAT5.K, R111.2
unnamed: D31.A, D33.C, U$6.BARREL
unnamed: D32.A, D34.C, U$6.PIN
unnamed: IC24.4, ICSP5.1
unnamed: PWR5.K, R112.2
unnamed: IC24.5, RA11.1
unnamed: IC21.15, R96.1
unnamed: IC21.12, R97.1
unnamed: IC21.10, R100.1
unnamed: IC21.6, R98.1
unnamed: IC21.2, R101.1
unnamed: IC21.4, R99.1
unnamed: C47.2, D35.2, X42.3
unnamed: A5.2, B5.2, E5.2, X42.4
unnamed: C46.2, CK5.1, E5.1, R114.2
unnamed: F5.2, X42.2
unnamed: R115.2, X43.5
unnamed: R116.2, X44.5
unnamed: R119.2, X45.5
unnamed: R117.2, X46.5
unnamed: R118.2, X47.5
unnamed: R120.2, X48.5
unnamed: R121.1, X43.4
unnamed: R122.1, X44.4
unnamed: R123.1, X45.4
unnamed: R124.1, X46.4
unnamed: R125.1, X47.4
unnamed: R126.1, X48.4
unnamed: B6.1, C55.1, IN6.4, R127.1
unnamed: D36.A, IC26.2, R127.2
unnamed: IC26.7, R129.2
unnamed: A6.1, D36.C, D41.1, IC26.3, IN6.5
unnamed: DAT6.K, R130.2
unnamed: D37.A, D39.C, U$7.BARREL
unnamed: D38.A, D40.C, U$7.PIN
unnamed: IC28.4, ICSP6.1
unnamed: PWR6.K, R131.2
unnamed: IC28.5, RA13.1
unnamed: IC25.15, R115.1
unnamed: IC25.12, R116.1
unnamed: IC25.10, R119.1
unnamed: IC25.6, R117.1
unnamed: IC25.2, R120.1
unnamed: IC25.4, R118.1
unnamed: C55.2, D41.2, X49.3
unnamed: A6.2, B6.2, E6.2, X49.4
unnamed: C54.2, CK6.1, E6.1, R133.2
unnamed: F6.2, X49.2
unnamed: R134.2, X50.5
unnamed: R135.2, X51.5
unnamed: R138.2, X52.5
unnamed: R136.2, X53.5
unnamed: R137.2, X54.5
unnamed: R139.2, X55.5
unnamed: R140.1, X50.4
unnamed: R141.1, X51.4
unnamed: R142.1, X52.4
unnamed: R143.1, X53.4
unnamed: R144.1, X54.4
unnamed: R145.1, X55.4
unnamed: B7.1, C63.1, IN7.4, R146.1
unnamed: D42.A, IC30.2, R146.2
unnamed: IC30.7, R148.2
unnamed: A7.1, D42.C, D47.1, IC30.3, IN7.5
unnamed: DAT7.K, R149.2
unnamed: D43.A, D45.C, U$8.BARREL
unnamed: D44.A, D46.C, U$8.PIN
unnamed: IC32.4, ICSP7.1
unnamed: PWR7.K, R150.2
unnamed: IC32.5, RA15.1
unnamed: IC29.15, R134.1
unnamed: IC29.12, R135.1
unnamed: IC29.10, R138.1
unnamed: IC29.6, R136.1
unnamed: IC29.2, R139.1
unnamed: IC29.4, R137.1
unnamed: C63.2, D47.2, X56.3
unnamed: A7.2, B7.2, E7.2, X56.4
unnamed: C62.2, CK7.1, E7.1, R152.2
unnamed: F7.2, X56.2
VCC: C2.1, C3.1, C4.1, C5.+, IC1.2, IC2.1, IC3.1, IC4.8, ICSP.2, PWR.A, R5.2, R7.2, R9.2, R11.2, R13.2, R15.2, R18.1
VCC1: C9.1, C11.+, C12.1, C13.1, IC5.1, IC6.8, IC7.2, IC8.1, ICSP1.2, PWR1.A, R26.2, R27.2, R28.2, R29.2, R30.2, R31.2, R33.1
VCC2: C17.1, C19.+, C20.1, C21.1, IC9.1, IC10.8, IC11.2, IC12.1, ICSP2.2, PWR2.A, R45.2, R46.2, R47.2, R48.2, R49.2, R50.2, R52.1
VCC3: C25.1, C27.+, C28.1, C29.1, IC13.1, IC14.8, IC15.2, IC16.1, ICSP3.2, PWR3.A, R64.2, R65.2, R66.2, R67.2, R68.2, R69.2, R71.1
VCC4: C33.1, C35.+, C36.1, C37.1, IC17.1, IC18.8, IC19.2, IC20.1, ICSP4.2, PWR4.A, R83.2, R84.2, R85.2, R86.2, R87.2, R88.2, R90.1
VCC5: C41.1, C43.+, C44.1, C45.1, IC21.1, IC22.8, IC23.2, IC24.1, ICSP5.2, PWR5.A, R102.2, R103.2, R104.2, R105.2, R106.2, R107.2, R109.1
VCC6: C49.1, C51.+, C52.1, C53.1, IC25.1, IC26.8, IC27.2, IC28.1, ICSP6.2, PWR6.A, R121.2, R122.2, R123.2, R124.2, R125.2, R126.2, R128.1
VCC7: C57.1, C59.+, C60.1, C61.1, IC29.1, IC30.8, IC31.2, IC32.1, ICSP7.2, PWR7.A, R140.2, R141.2, R142.2, R143.2, R144.2, R145.2, R147.1
VIN: C1.1, C6.+, D2.C, D4.C, IC1.3
VIN1: C8.1, C10.+, D7.C, D8.C, IC7.3
VIN2: C16.1, C18.+, D13.C, D14.C, IC11.3
VIN3: C24.1, C26.+, D19.C, D20.C, IC15.3
VIN4: C32.1, C34.+, D25.C, D26.C, IC19.3
VIN5: C40.1, C42.+, D31.C, D32.C, IC23.3
VIN6: C48.1, C50.+, D37.C, D38.C, IC27.3
VIN7: C56.1, C58.+, D43.C, D44.C, IC31.3
