hotchk155/banana-split/(commit log)

2015-10-12 pcb ready
    [mini-MIDI-Splitter.brd]
2016-01-30 add component values
    [mini-MIDI-Splitter.brd, mini-MIDI-Splitter.sch]
2016-06-14 REV3 PCB
    [mini-MIDI-Splitter.brd, mini-MIDI-Splitter.sch]
2016-11-25 V4 - Grounding output GND pins!
    [mini-MIDI-Splitter.brd, mini-MIDI-Splitter.sch]
2018-04-30 checkin stuff
    [banana-split-BOM.xlsx]
2019-07-11 V5 PCB
    [banana-split.brd, banana-split.sch]
2019-08-19 v6 candidate
    [banana-split.brd, banana-split.sch]
2019-09-06 V7 PCB
    [banana-split.brd, banana-split.sch]
2019-09-07 V7 - layers tweak
    [banana-split.brd]
2019-09-07 v7 panel
    [banana-split-panel.brd]
2019-09-08 v7 prod?
    [banana-split-panel.brd]
2019-10-16 changes for v7
    [banana-split-BOM.xlsx]
2020-06-03 fix issue with ground pour on panel
    [banana-split-panel.brd]
2025-12-12 PCBA setup
    [banana-split-bom-jlc.xls, banana-split-bom.xlsx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]
