hotchk155/banana-split/(notices)

Notices in the files:
parts and their libraries:
tag-connect: ©2009 ROFA.cz - modified and updated by Robert Darlington ‹rdarlington@gmail.com›
